hdmkalhara/EE2120-Temperature_Node/Poster.png

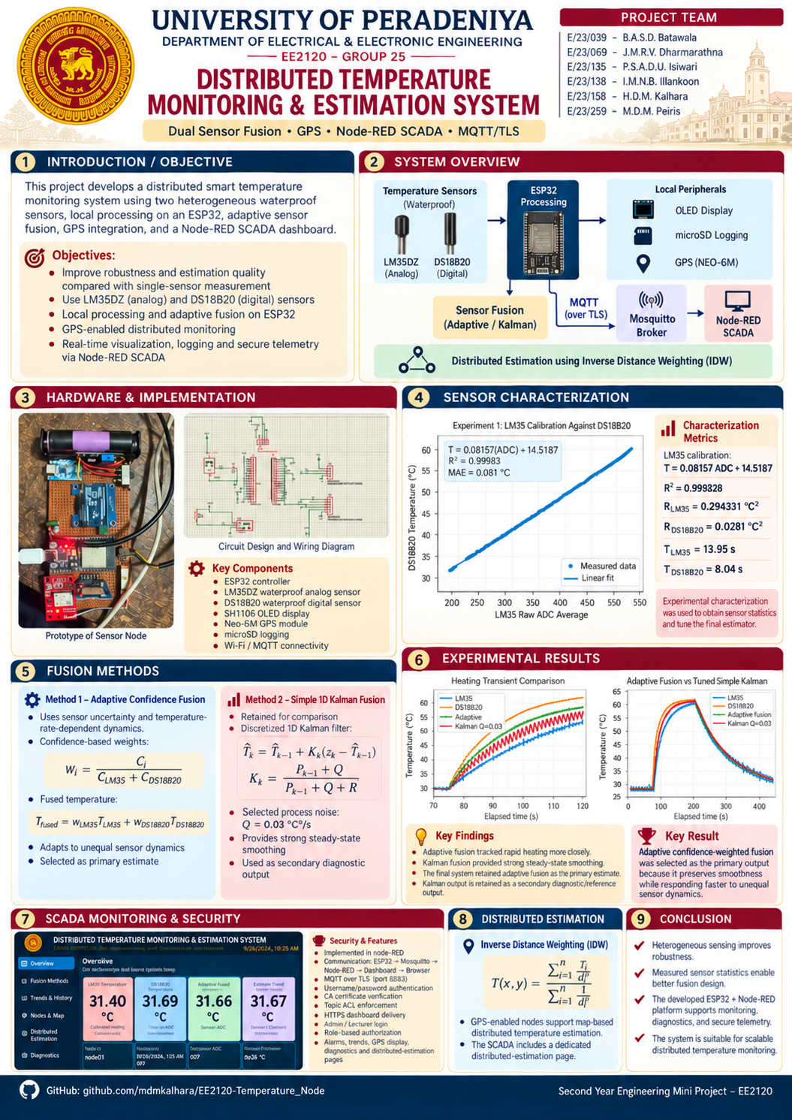
Poster.png
