hdmkalhara/EE2120-Temperature_Node/hardware-schematics/Prototype.jpeg

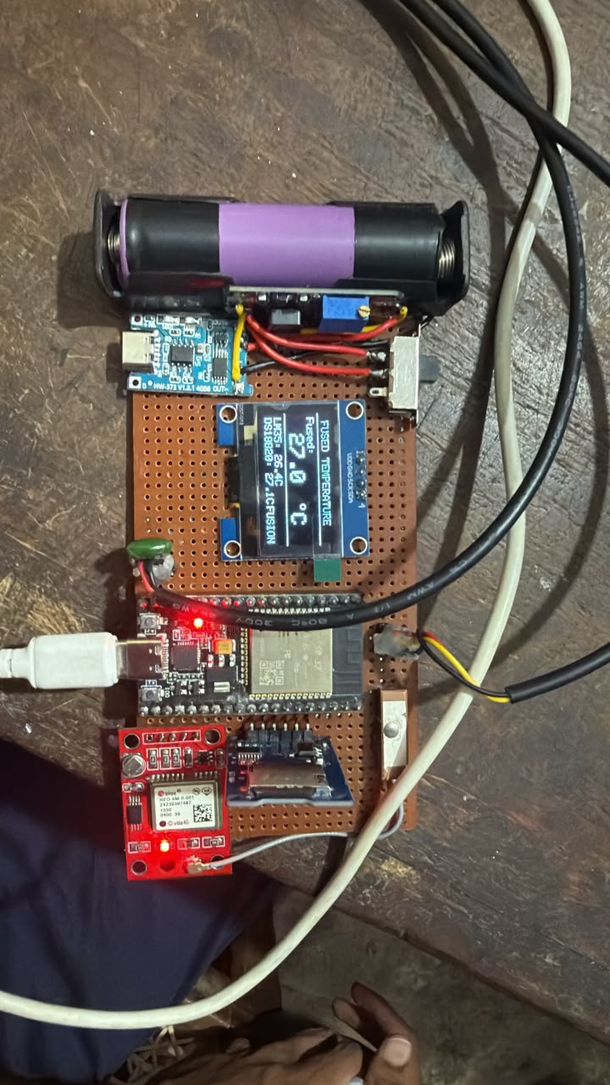
hardware-schematics/Prototype.jpeg
