hdmkalhara/EE2120-Temperature_Node/hardware-schematics/Ptotype_modified.jpeg

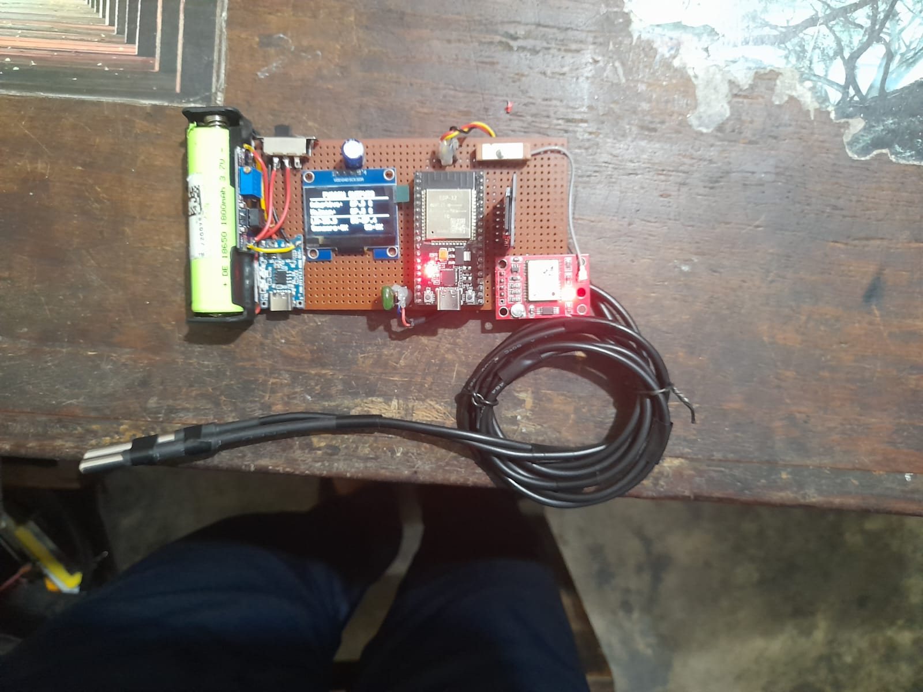
hardware-schematics/Ptotype_modified.jpeg
