hdmkalhara/EE2120-Temperature_Node/wiring diagram.jpeg

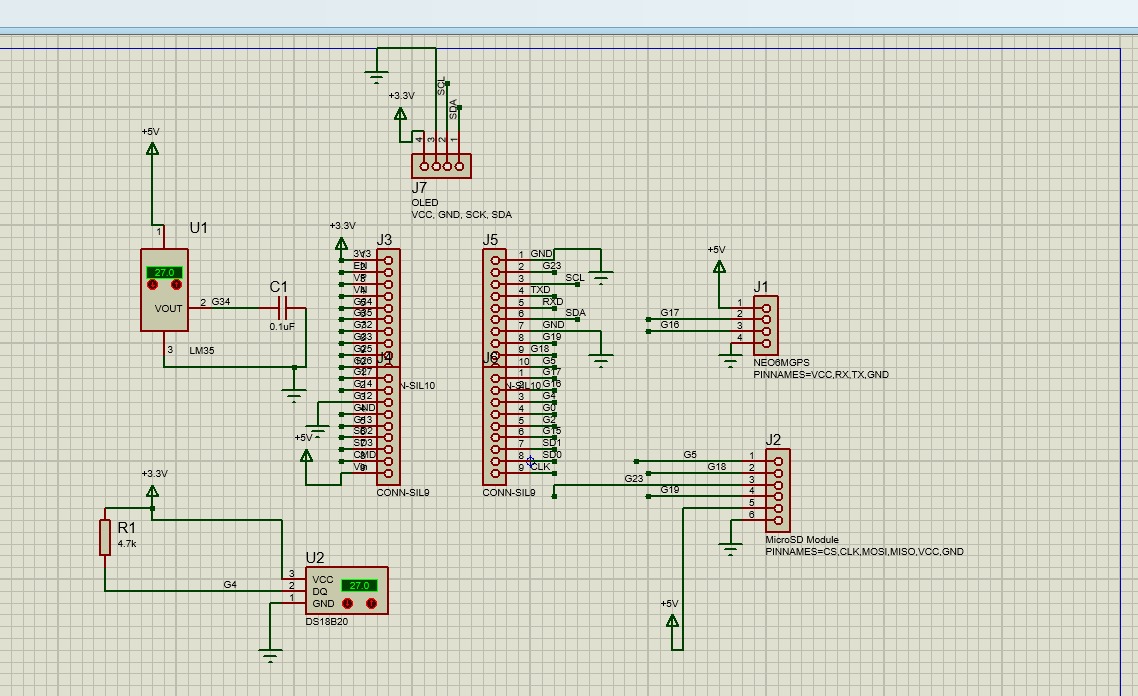
wiring diagram.jpeg
